AgustinAllegui/temperatura_raspberry/Prototipo/Hardware/distribucion de pines.ods

Descripcion | WiringPi | Pin fisico | comentario
termocupla CS | 3 | 15
termocupla MOSI | SPI0 MOSI | 19 | no conectar
termocupla MISO | SPI0 MISO | 21
termocupla CLK | SPI0 SCLK | 23
PT100 MOSI | 4 | 16
PT100 MISO | 5 | 18
PT100 CLK | 0 | 11
PT100 CS | 2 | 13
Rele | 7 | 7
LED app abierta | 23 | 33
LED Experimento | 22 | 31
LED Rele | 21 | 29
Boton parada emergencia | 26 | 32
