AgustinAllegui/temperatura_raspberry/Files/Pruebas/seno.ods

% seno
incremento |  |  | amplitud |  | offset
2,5 |  |  | -5 |  | 7
0 | 0 | 0 | 0 | 0 | 7
2,5 | 0,043633231299858 | 0,043619387365336 | -0,21809693682668 | -0,2 | 6,8
5 | 0,087266462599717 | 0,087155742747658 | -0,435778713738291 | -0,4 | 6,6
7,5 | 0,130899693899575 | 0,130526192220052 | -0,652630961100258 | -0,6 | 6,4
10 | 0,174532925199433 | 0,17364817766693 | -0,868240888334652 | -0,8 | 6,2
12,5 | 0,218166156499291 | 0,216439613938103 | -1,08219806969051 | -1 | 6
15 | 0,261799387799149 | 0,258819045102521 | -1,2940952255126 | -1,2 | 5,8
17,5 | 0,305432619099008 | 0,300705799504273 | -1,50352899752137 | -1,5 | 5,5
20 | 0,349065850398866 | 0,342020143325669 | -1,71010071662834 | -1,7 | 5,3
22,5 | 0,392699081698724 | 0,38268343236509 | -1,91341716182545 | -1,9 | 5,1
25 | 0,436332312998582 | 0,422618261740699 | -2,1130913087035 | -2,1 | 4,9
27,5 | 0,479965544298441 | 0,461748613235034 | -2,30874306617517 | -2,3 | 4,7
30 | 0,523598775598299 | 0,5 | -2,5 | -2,5 | 4,5
32,5 | 0,567232006898157 | 0,537299608346824 | -2,68649804173412 | -2,6 | 4,4
35 | 0,610865238198015 | 0,573576436351046 | -2,86788218175523 | -2,8 | 4,2
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
