AgustinAllegui/temperatura_raspberry/Prototipo/Hardware/Etiquetas/Todo.pdf

+

_

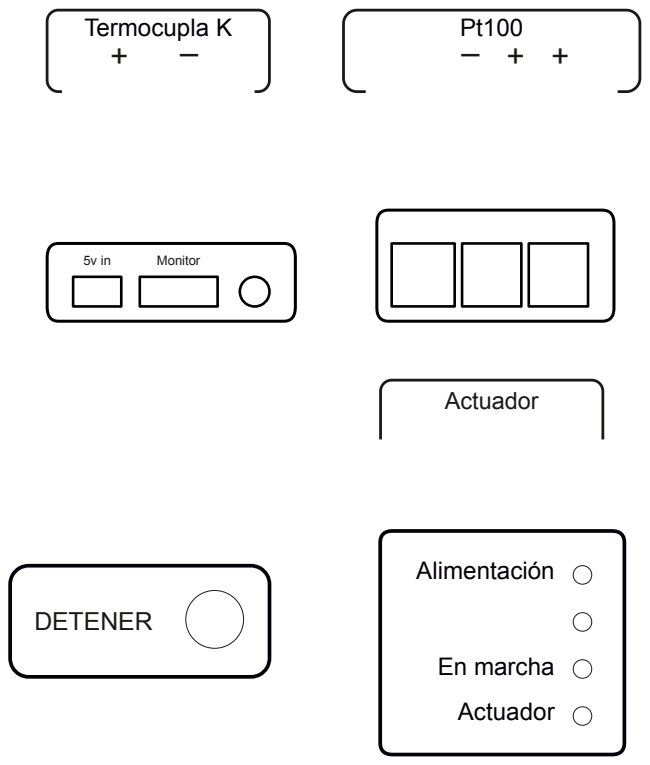
[picture p3: page 1]
Actuador; Alimentación; En marcha; Termocupla K; Monitor; DETENER
