AgustinAllegui/temperatura_raspberry/Prototipo/Hardware/Frente/Frente.kicad_pcb

## KiCad design Prototipo/Hardware/Frente/Frente.kicad_pcb (2019-11-12)

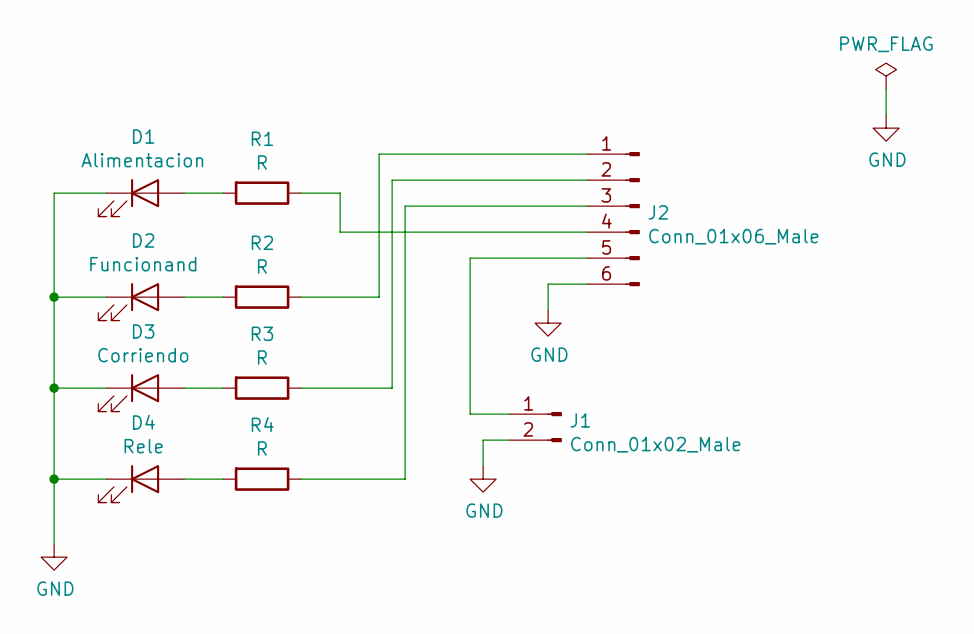
[picture p4: schematic Frente.sch]

Parts:
D1: Alimentacion; LED_D5.0mm
D2: Funcionand; LED_D5.0mm
D3: Corriendo; LED_D5.0mm
D4: Rele; LED_D5.0mm
J1: Conn_01x02_Male; PinHeader_1x02_P2.54mm_Horizontal
J2: Conn_01x06_Male; PinHeader_1x06_P2.54mm_Horizontal
R1, R2, R3, R4: R; R_Axial_DIN0207_L6.3mm_D2.5mm_P7.62mm_Horizontal

Connections:
GND: D1.1 (K), D2.1 (K), D3.1 (K), D4.1 (K), J1.2, J2.6
unnamed: D1.2 (A), R1.2
unnamed: D2.2 (A), R2.2
unnamed: D3.2 (A), R3.2
unnamed: D4.2 (A), R4.2
unnamed: J1.1, J2.5
unnamed: J2.1, R2.1
unnamed: J2.2, R3.1
unnamed: J2.3, R4.1
unnamed: J2.4, R1.1

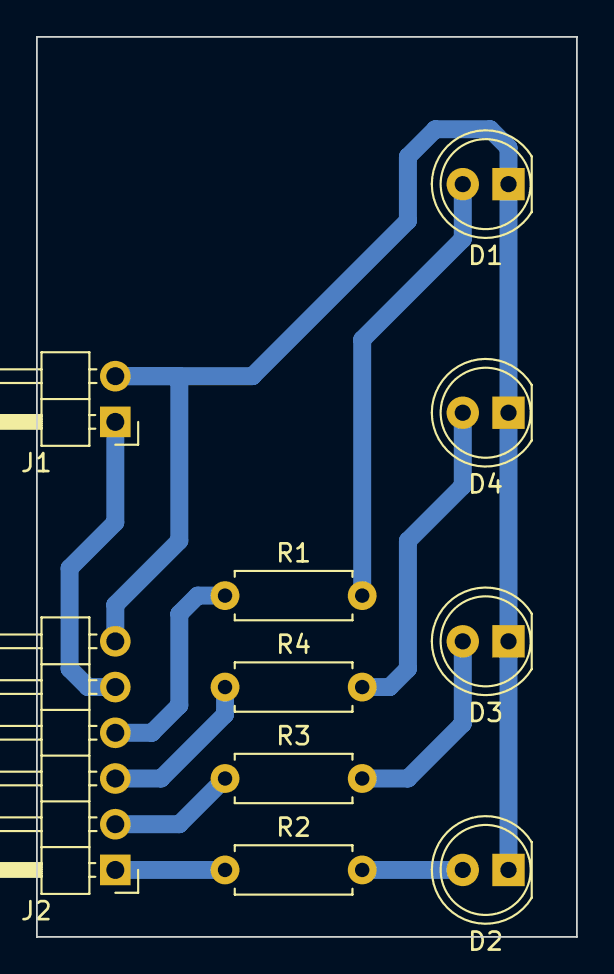
[picture p5: board Frente.kicad_pcb from above]

Board: 2 copper layers, 30.0 x 50.0 mm, 10 parts (0 on the bottom side), 10 nets.
