AgustinAllegui/temperatura_raspberry/Prototipo/Hardware/Conexiones/Conexiones.kicad_pcb

## KiCad design Prototipo/Hardware/Conexiones/Conexiones.kicad_pcb (2019-11-11, an earlier design)

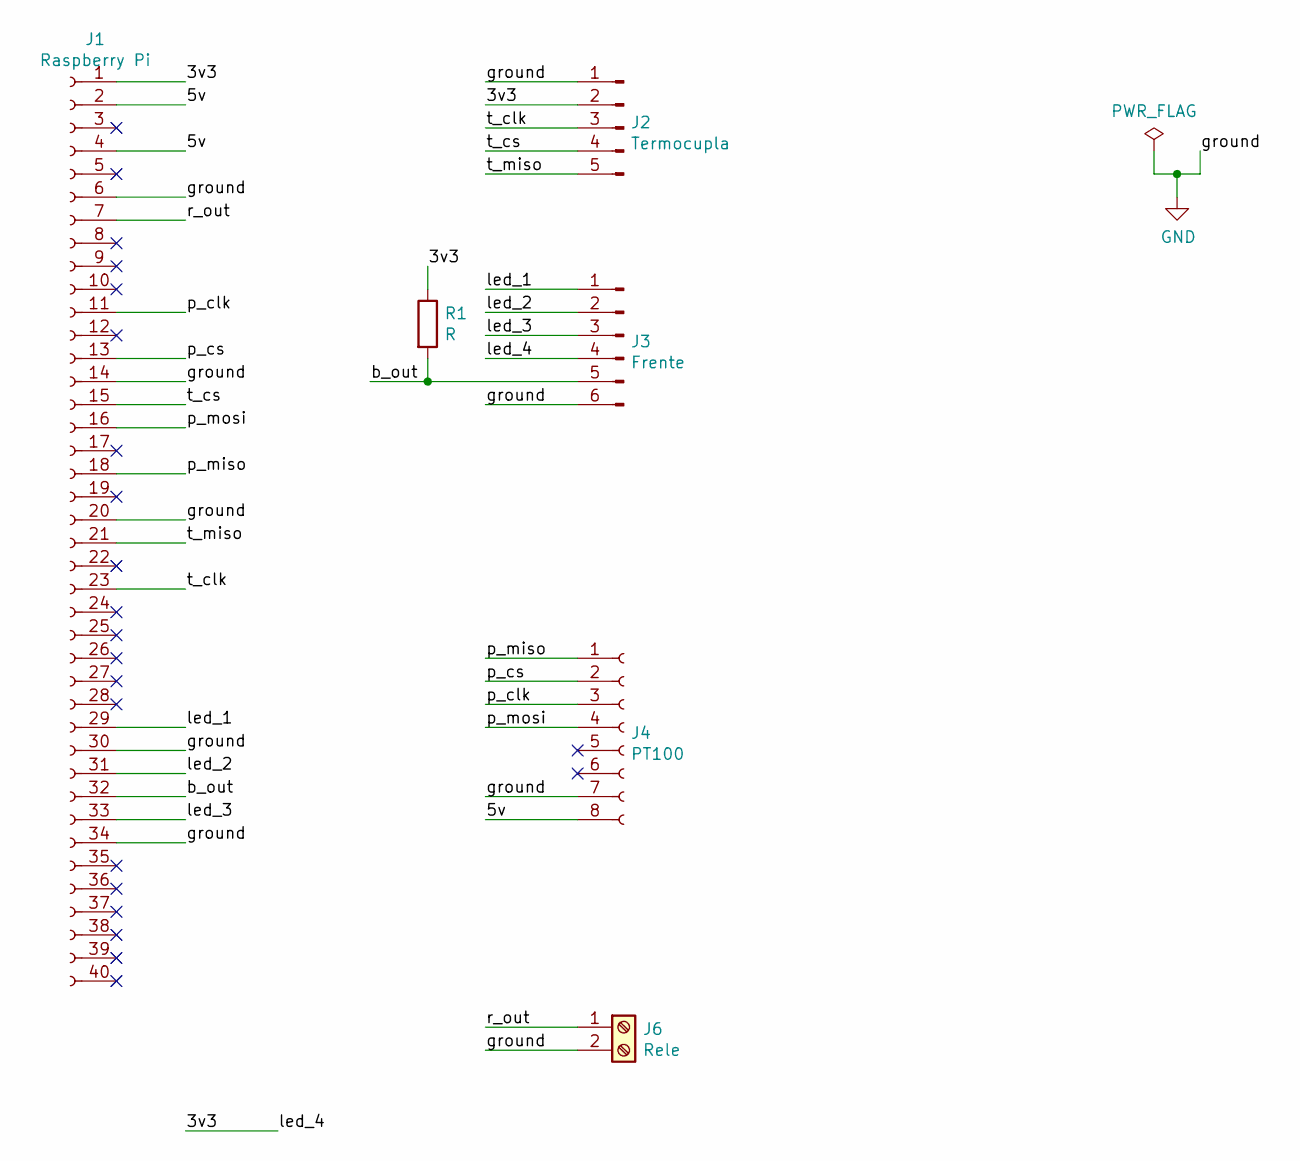
[picture p6: schematic Conexiones.sch]

Parts:
J1: Raspberry Pi; PinSocket_2x20_P2.54mm_Vertical
J2: Termocupla; Molex_KK-254_AE-6410-05A_1x05_P2.54mm_Vertical
J3: Frente; Molex_KK-254_AE-6410-06A_1x06_P2.54mm_Vertical
J4: PT100; PinSocket_1x08_P2.54mm_Vertical
J6: Rele; TerminalBlock_bornier-2_P5.08mm
R1: R; R_Axial_DIN0207_L6.3mm_D2.5mm_P10.16mm_Horizontal

Connections:
/3v3: J1.1, J2.2, J3.4, R1.1
/5v: J1.2, J1.4, J4.8
/b_out: J1.32, J3.5, R1.2
/led_1: J1.29, J3.1
/led_2: J1.31, J3.2
/led_3: J1.33, J3.3
/p_clk: J1.11, J4.3
/p_cs: J1.13, J4.2
/p_miso: J1.18, J4.1
/p_mosi: J1.16, J4.4
/r_out: J1.7, J6.1
/t_clk: J1.23, J2.3
/t_cs: J1.15, J2.4
/t_miso: J1.21, J2.5
GND: J1.6, J1.14, J1.20, J1.30, J1.34, J2.1, J3.6, J4.7, J6.2

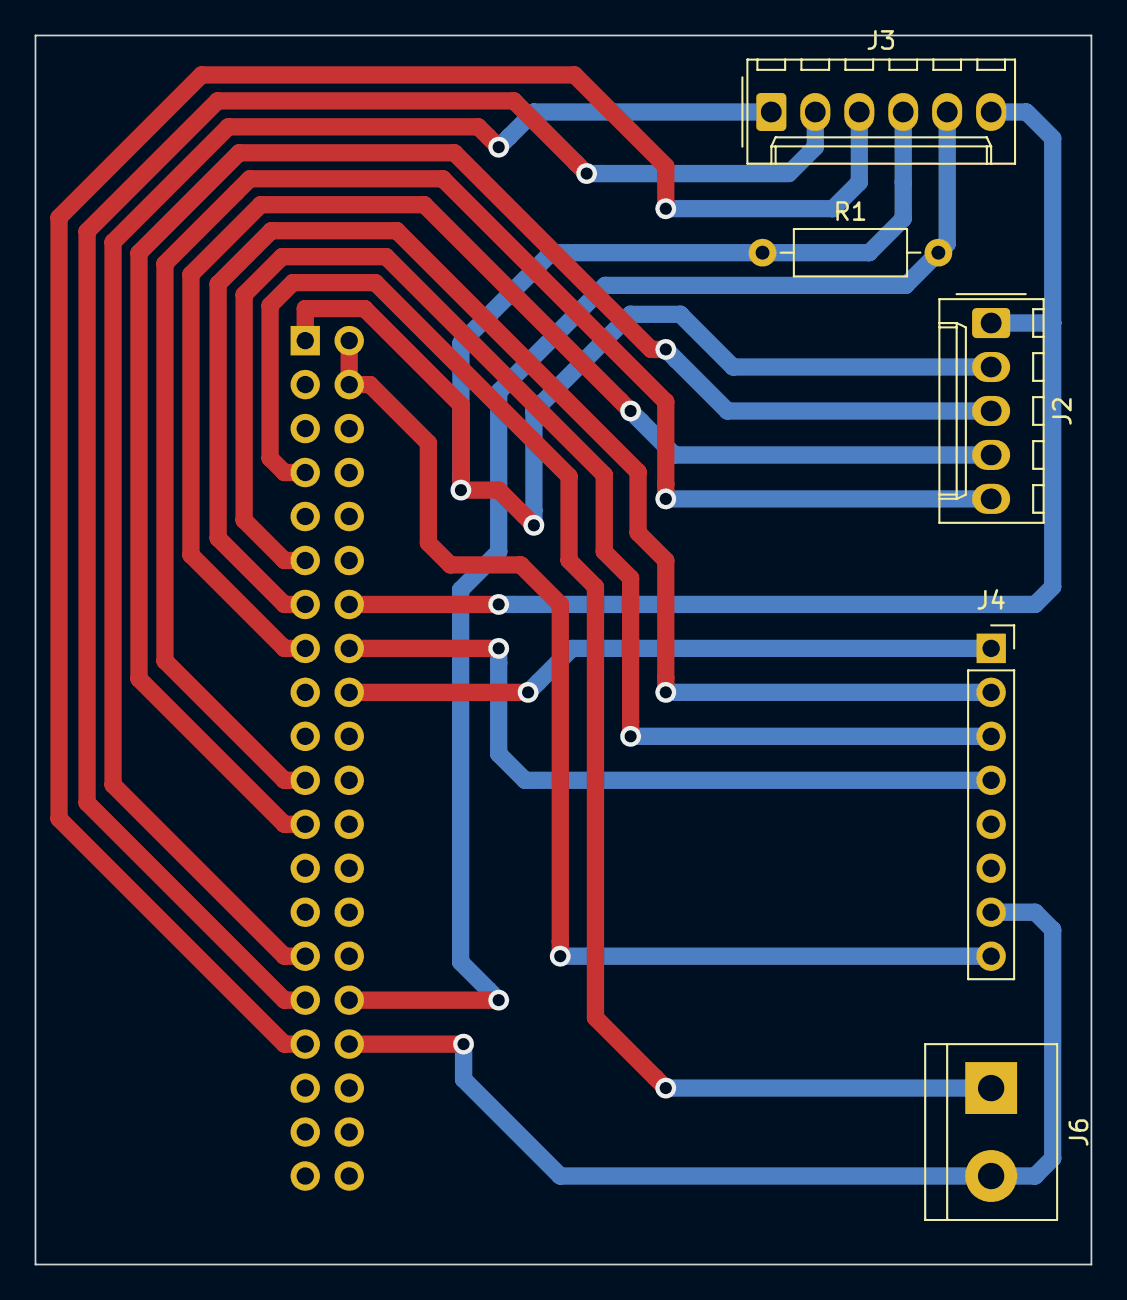
[picture p7: board Conexiones.kicad_pcb from above]

Board: 2 copper layers, 61.0 x 71.0 mm, 6 parts (1 on the bottom side), 15 nets.
