AgustinAllegui/temperatura_raspberry/Prototipo/Hardware/Conexiones/doble faz.kicad_pcb

## KiCad design Prototipo/Hardware/Conexiones/doble faz.kicad_pcb (2020-03-03)

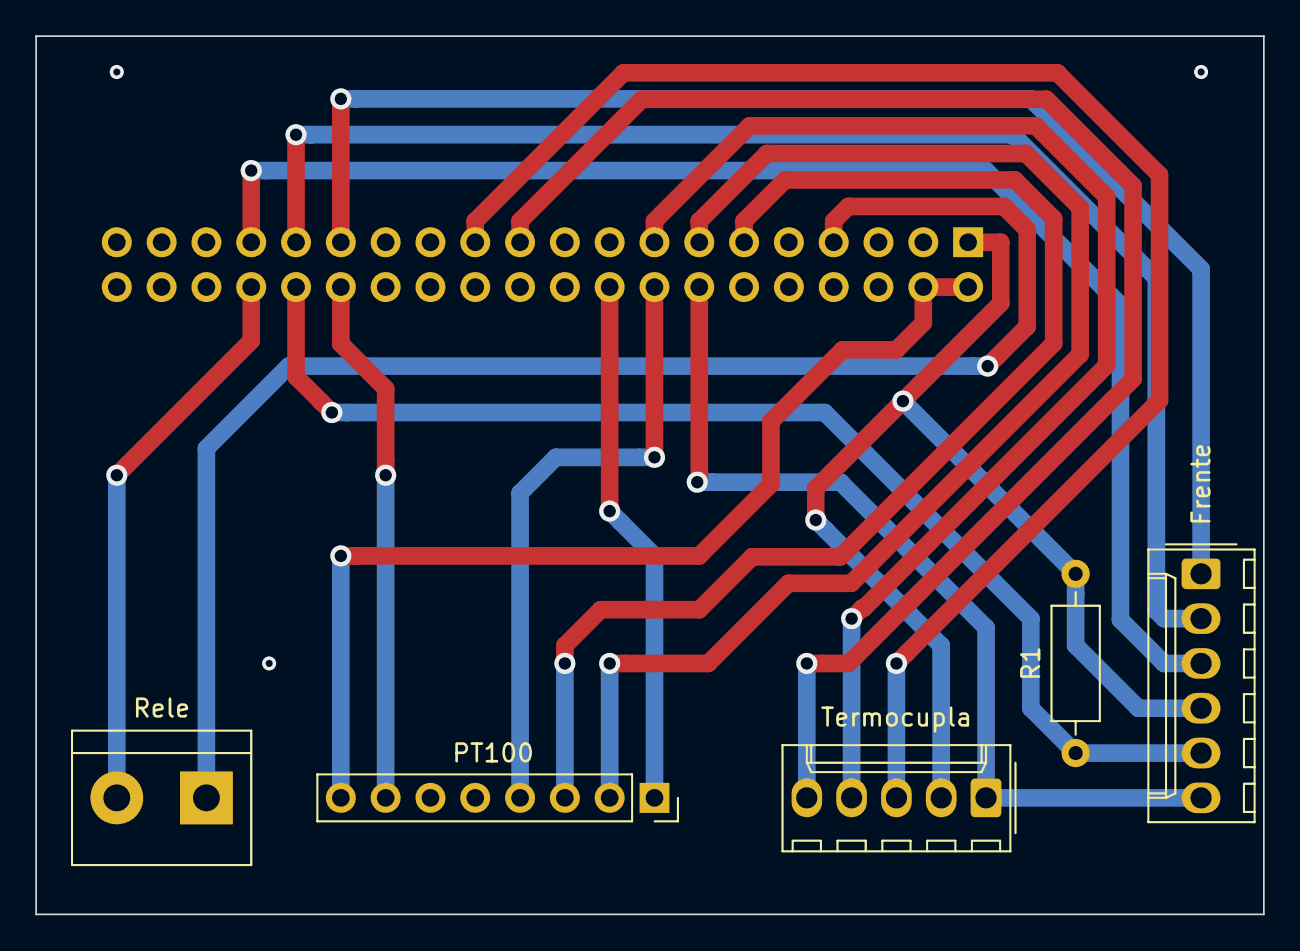
[picture p8: board doble faz.kicad_pcb from above]

Board: 2 copper layers, 69.6 x 49.8 mm, 6 parts (1 on the bottom side), 15 nets.

Parts:
Frente: Frente; Molex_KK-254_AE-6410-06A_1x06_P2.54mm_Vertical
J1: Raspberry Pi; PinSocket_2x20_P2.54mm_Vertical
PT100: PT100; PinSocket_1x08_P2.54mm_Vertical
R1: R; R_Axial_DIN0207_L6.3mm_D2.5mm_P10.16mm_Horizontal
Rele: Rele; TerminalBlock_bornier-2_P5.08mm
Termocupla: Termocupla; Molex_KK-254_AE-6410-05A_1x05_P2.54mm_Vertical

Connections:
/3v3: Frente.4, J1.1, R1.1, Termocupla.2
/5v: J1.2, J1.4, PT100.8
/b_out: Frente.5, J1.32, R1.2
/led_1: Frente.1, J1.29
/led_2: Frente.2, J1.31
/led_3: Frente.3, J1.33
/p_clk: J1.11, PT100.3
/p_cs: J1.13, PT100.2
/p_miso: J1.18, PT100.1
/p_mosi: J1.16, PT100.4
/r_out: J1.7, Rele.1
/t_clk: J1.23, Termocupla.3
/t_cs: J1.15, Termocupla.4
/t_miso: J1.21, Termocupla.5
GND: Frente.6, J1.6, J1.14, J1.20, J1.30, J1.34, PT100.7, Rele.2, Termocupla.1
