AgustinAllegui/temperatura_raspberry/Prototipo/control_temperatura/graficocustom.h

#ifndef GRAFICO_H
#define GRAFICO_H

#include "Libs/qcustomplot.h"
#include "dev_op.h"


class GraficoCustom : public QCustomPlot
{
public:
    explicit GraficoCustom(QWidget *parent);
    ~GraficoCustom();

    //interfaz
    void limpiar();
    void rearmar(const bool phFlag_);

    void setRef(QVector<double> referencia_, QVector<double> tiempo_);
    void addPoint(const double t_, const double referencia_, const double temperatura_, const double u_);
    void addPhPoint(const double t_, const double ph_);

    void showAll(QVector<double> tiempo, QVector<double> referencia, QVector<double> temperatura, QVector<double> u, QVector<double> ph);
    void showAll(QVector<double> tiempo, QVector<double> referencia, QVector<double> temperatura, QVector<double> u);


private:
    //metodos privados
    void reescalar();

    //variables internas
    bool phShowed;

    // elementos del grafico
    QCPAxisRect *graficoPh;
    QCPGraph *lineaRef, *lineaTemp;
    QCPGraph *lineaU;
    QCPGraph *lineaPh;

//    QCPLegend *leyenda;
    QCPMarginGroup *margenIzq, *margenDer;
//    QSharedPointer<QCPAxisTickerTime> tiempoTick;
};

#endif // GRAFICO_H
