AgustinAllegui/temperatura_raspberry/Prototipo/control_temperatura/tscontainer.h

#ifndef TSCONTAINER_H
#define TSCONTAINER_H

// contenedor de la variable Ts para que sea accesible a todos los objetos

class TsContainer
{
public:
    static double Ts;
};

//double TsContainer::Ts = 1;


#endif // TSCONTAINER_H
