AgustinAllegui/temperatura_raspberry/Tools/SPI/spi_tester/mainwindow.cpp

#include "mainwindow.h"
#include "ui_mainwindow.h"

MainWindow::MainWindow(QWidget *parent) :
    QMainWindow(parent),
    ui(new Ui::MainWindow)
{
    ui->setupUi(this);
    pinCs0 = 3;
    pinCs1 = 2;

#if CURRENT_PC == PC_RASPBERRY_PI
    wiringPiSetup();
    ui->sb_pin0->setValue(pinCs0);
    ui->sb_pin1->setValue(pinCs1);

    pinMode(pinCs0,OUTPUT);
    pinMode(pinCs1,OUTPUT);
    digitalWrite(pinCs0,HIGH);
    digitalWrite(pinCs1,HIGH);
#endif

}

MainWindow::~MainWindow()
{
    delete ui;
}

void MainWindow::on_l_in_returnPressed()
{
    on_b_enviar_clicked();
}

void MainWindow::on_b_enviar_clicked()
{
    DTRACE("Enviar");
    //configurar canal
    int canal;
    int velocidad;
    if(ui->rb_ch0->isChecked()){
        canal = 0;
        velocidad = ui->l_speed0->text().toInt();
    }else if(ui->rb_ch1->isChecked()){
        canal = 1;
        velocidad = ui->l_speed1->text().toInt();
    }else{
        DLOG("no se selecciono ningun canal");
        return;
    }

    if( (velocidad < 500000) || (velocidad > 32000000) ){
        DLOG("Velocidad fuera de rango");
        return;
    }

    DDEBUG("canal" << canal);
    DDEBUG("velocidad" << velocidad);

#if CURRENT_PC == PC_RASPBERRY_PI
    if(wiringPiSPISetupMode(canal, velocidad, 1) == -1){
        DLOG("no se pudo configurar el canal");
        return;
    }

#endif


    //convertir datos si necesario

    char in_char[ui->l_in->text().length()];
    int largo;
    QByteArray in_byteArray;

    if(ui->rb_hex->isChecked()){
        in_byteArray = QByteArray::fromHex(ui->l_in->text().toLatin1());
    }else if(ui->rb_ascii->isChecked()){
        in_byteArray = ui->l_in->text().toLatin1();
    }else{
        DLOG("Formato no seleccionado");
        return;
    }

    DDEBUG("datos a enviar" << in_byteArray);

    largo = in_byteArray.length();
    for(int i = 0; i<largo; i++){
        in_char[i] = in_byteArray[i];
    }


    int enviados = 0;

#if CURRENT_PC == PC_RASPBERRY_PI
    if(ui->rb_ch0->isChecked()){
        digitalWrite(pinCs0,LOW);
        DDEBUG("pin" << pinCs0 << "en 0");
    }else if(ui->rb_ch1->isChecked()){
        digitalWrite(pinCs1,LOW);
        DDEBUG("pin" << pinCs1 << "en 0");
    }else{
        return;
    }
    QThread::msleep(2);

    enviados = wiringPiSPIDataRW(canal, reinterpret_cast<unsigned char*>(in_char), largo);

    QThread::msleep(2);

    if(ui->rb_ch0->isChecked()){
        digitalWrite(pinCs0,HIGH);
        DDEBUG("pin" << pinCs0 << "en 1");
    }else if(ui->rb_ch1->isChecked()){
        digitalWrite(pinCs1,HIGH);
        DDEBUG("pin" << pinCs1 << "en 1");
    }else{
        return;
    }
#endif

    DDEBUG("cantidad de datos enviados" << enviados);

    QByteArray out_byteArray = QByteArray(in_char, largo);
    DDEBUG("out byteArray" << out_byteArray);
    DDEBUG("out byteArray hex" << out_byteArray.toHex());

    QString out_str = "";
    out_str.append(in_byteArray.toHex());
    out_str.append("->>");
    out_str.append(out_byteArray.toHex());

    ui->tb_out->append(out_str);
    ui->l_in->clear();

    return;
}



void MainWindow::on_b_limpiar_clicked()
{
    ui->tb_out->clear();
}
