AgustinAllegui/temperatura_raspberry/(commit log)

2019-10-09 primer commit
    [seno.ods]
2019-10-09 Falta: - Sensores - Rele - Graficos - Log
    verificado:
    - referencia (valores, simple y compleja)
    - controlador PID
    - temporizacion de muestreo
    - limite de tiempo
    - resumen
    - iniciar y detener experimento
    - controlador custom
    no funciona:
    - recuperarse de un experimento que fallo en iniciar
2019-10-10 añadida herramienta para testear SPI (solo interfaz)
2019-10-11 herramienta para testear SPI funcionando 100%
2019-10-11 agregada la seccion documentos con algunos documentos utiles
2019-10-11 planteado el procedimiento para probar la PT100
2019-10-13 listo el protocolo para evaluar testear la lectura de PT100
    [hex_bin_hex.xlsx]
2019-10-13 correcciones en herramientas
    [hex_bin_hex.ods]
2019-10-13 modificacion en spi_tester para usar el cs con pin GPIO
2019-10-18 agregado sketch de arduino para probar SPI (todavia no implementado)
2019-10-18 spi_tester de arduino listo para probar
2019-10-19 funciones de arduino_spi_tester arregladas. todavia no funciona
    [spi_tester_out.ino]
2019-10-20 agregado loopback test que funciona
    [hex_bin_hex.ods, hex_bin_hex.xlsx]
2019-10-22 avance en la generacion del grafico
2019-10-22 agregado generacion de vectores en referencia
2019-10-24 grafico de supervision funcionando
2019-10-24 el grafico dibuja la referencia inicial
2019-10-24 agregado mensaje de debugueo de error
    [algoritmo.cpp, controlsys.cpp, dev_op.h, input.cpp, mainwindow.h, output_rele.cpp, referencia.cpp]
2019-10-25 implementada la entrada de la termocupla
2019-10-26 excluido el directorio de compilacion del prototipo
2019-10-26 PT100 listo para probar
2019-10-27 mejorada la seleccion del dispositivo solo cambiando CURRENT_DEVICE
2019-10-29 implementado el logger excepto el exportar a .mat
2019-10-30 funcionando 100% el guardado de archivos incluyendo el *.mat
2019-10-31 agregado limite de saturacion en la salida
2019-11-01 salida rele lista para probar
2019-11-02 archivo pid interno corregido
2019-11-02 listo para probar en una planta real
2019-11-04 bugFix: no aplicaba el tiempo correcto del actuador
    [controlsys.cpp, graficocustom.cpp, mainwindow.cpp, mainwindow.h, output_rele.cpp, output_rele.h]
2019-11-04 bugFix: la medicion de la PT100 se congaba
    [algoritmo.cpp, controlsys.cpp, dev_op.h, graficocustom.cpp, input.cpp, input.h, logger.cpp, mainwindow.cpp]
2019-11-06 añadido archivo de configuracion ini con limites de seguridad para sensores
2019-11-11 agregada placa de conexiones
    [Conexiones.kicad_pcb, Conexiones.sch]
2019-11-12 añadido PCB del frente de la caja
    [Frente.kicad_pcb, Frente.sch]
2019-11-13 añadido manejo de los LEDs de la tapa
2019-11-13 agregados controladores para probar
2019-11-13 agregada lista con distribucion de pines
    [distribucion de pines.ods]
2019-11-14 designado el pin para la parada de emergencia
    [distribucion de pines.ods]
2019-11-18 agregada etiqueta para Leds
2019-11-20 cambio de los mensajes de error
    [algoritmo.cpp, controlsys.cpp, dev_op.h, graficocustom.cpp, input.cpp, logger.cpp, mainwindow.cpp, mainwindow.h]
2019-11-20 agregado numero de version al iniciar
2019-11-28 Implementado boton parada emergencia
    Se implementaron las funciones correspondientes al boton parada
    de emergencia presente en el frente del gabinete.
2019-11-28 Cambio numero de version a 1.0.1
2019-11-28 cambio en el mensaje de error
    [dev_op.h]
2019-11-28 cambiados mensajes de sensores en pantalla
2019-12-02 quitado grafico de PH en resultados iniciales
2019-12-02 quitado checkbox para habilitar sensor de PH
2019-12-02 cambio numero de version a 1.0.3
2019-12-02 cambiado limite de seguridad de PT100 a 300
2019-12-02 agregado el limite de seguridad al resumen
2020-02-09 inicio de diseño placa conexiones doble faz
    [conexiones v2.kicad_pcb, doble faz.kicad_pcb]
2020-02-14 placa doble faz lista
    [doble faz.kicad_pcb]
2020-02-24 Correccion de rutas de archivo
    Las rutas se cambiaron para que la carpeta del proyecto se encuentre en ~/.
2020-03-03 placa de frente reducida a 5x2.5cm
    [frente 2.kicad_pcb]
2020-03-07 corregidas etiquetas de caja
2020-03-17 Arreglados archivos de ejemplos
    - Se quitaron los controladores con PH.
    - Se dejaron solo los archivos explicados en el manual.
2020-03-20 Agregados prototipos de funciones personalizadas a la interfaz
2020-03-21 BugFix: Guardado de archivos
    - Al guardarse los archivos csv no escribia las comas.
    - Ahora, al seleccionar un filtro de archivos, lo guarda con la extension
    correspondiente
    [logger.cpp, mainwindow.cpp]
2020-03-21 Aumentada fuente de botones de supervision
2020-09-06 Agregada constante C a algoritmo PID
