AgustinAllegui/temperatura_raspberry/(notices)

Notices in the files:
Documentos/sensores/pt100/arduino-max31865-master/MAX31865.cpp:
This program is free software: you can redistribute it and/or modify
it under the terms of the GNU General Public License as published by
the Free Software Foundation, either version 3 of the License, or
(at your option) any later version.
